BehrensG/ETH1CJTAG/hardware/project/ETH1CJTAG/ETH1CJTAG.ods

Id | Designator | Package | Quantity | Designation | Supplier and ref | Price (Euro) | Sum (Euro)
1 | R734,R724,R717,R1149,R221,R220,R715,R1148,R1146,R1144,R1135,R1134,R1133,R1132,R1131,R1130,R1129,R1128,R1125,R1124,R1123,R1122,R1121,R1120,R1119,R1118,R1117,R1109,R1016,R1015,R1012,R1011,R1008,R1007,R1004,R1003,R905,R722,R721,R720,R716,R703,R623,R619,R618,R612,R506,R503,R306,R305,R304,R303,R302,R301,R222,R216 | R_0603_G_Pad1.05x0.95mm_HandSolder | 56 | 10k | 594-MCT06030C1002FP5 | 0.14 | 7.84
2 | R513,R907,R510 | R_1206_3216Metric_Pad1.42x1.75mm_HandSolder | 3 | 0/0.75W | 71-CRCW12060000Z0EAH | 0.4 | 1.2
3 | C518,C513,C512,C507 | C_1206_3216Metric_Pad1.42x1.75mm_HandSolder | 4 | 470p/2kV | 603-CC126KKX7RDBB471 | 0.28 | 1.12
4 | J801 | Socket_DIN41612-CaseC1-AC-Male-64Pin-2rows | 1 | C64AC | 617-09-03-164-6921 | 2.58 | 2.58
5 | M101 | 60817-096 | 1 | 60817-096 |  |  | 0
6 | R617,R616,R615,R613 | R_0603_1608Metric_Pad1.05x0.95mm_HandSolder | 4 | 10k/0.1% | 71-TNPW060310K0BEEN | 0.83 | 3.32
7 | C215,C211 | C_1206_3216Metric_Pad1.42x1.75mm_HandSolder | 2 | 1n/2kV | 603-CC206KKX7RDBB102 | 0.37 | 0.74
8 | R204,R1147,R203,R202,R201 | R_0603_1608Metric_Pad1.05x0.95mm_HandSolder | 5 | 49R9 | 594-MCT06030C4999FP5 | 0.23 | 1.15
9 | C210,C201,C1104,C704,C1105,C1101,C1009,C1008,C1007,C1006,C1005,C1001,C911,C909,C907,C906,C905,C904,C903,C902,C901,C724,C723,C722,C721,C720,C719,C718,C717,C716,C715,C714,C713,C712,C707,C706,C702,C630,C629,C628,C627,C626,C622,C621,C620,C619,C616,C612,C609,C607,C606,C413,C412,C409,C406,C403,C303,C302,C301,C212,C207,C206,C205,C204,C202 | C_0603_A_Pad1.05x0.95mm_HandSolder | 65 | 100n | 80-C0603C104K5RAUTLR | 0.13 | 8.45
10 | U1101 | GCS2 | 1 | chiliSOM | NC | 0 | 0
11 | D602 | D_SMA | 1 | SK33A | 833-SK33A-LTP | 0.508 | 0.508
12 | L201 | 749010012A | 1 | 749010012A | 710-749010012A | 3.21 | 3.21
13 | U201,U203 | SO8E | 2 | LC03-3.3 | 947-LC03-3.3.TBT | 3.53 | 7.06
14 | J802 | 615008145221 | 1 | 615008145221 | 710-615008145221 | 3.77 | 3.77
15 | U706 | LQFP-64_10x10mm_P0.5mm | 1 | FT2232H | 895-FT2232HL | 5.86 | 5.86
16 | L403,L402,L401 | 744233121 | 3 | 744233121 | 710-744233121 | 1.25 | 3.75
17 | D1102 | D_SOD-323 | 1 | PMEG4005AEA | 771-PMEG4005AEAZ | 0.419 | 0.419
18 | D901 | D_SMB | 1 | SMBJ5.0A | 581-SMBJ5.0A | 0.48 | 0.48
19 | D603,D505 | D_SMB | 2 | P6SMB30CA | 652-P6SMB30CA | 0.384 | 0.768
20 | D502 | D_SMB | 1 | P6SMB6.8CA | 576-P6SMB6.8CA | 0.402 | 0.402
21 | U504 | SOT-23-6_Handsoldering | 1 | MAX5902 | 700-MAX5902ACEUTT | 4.09 | 4.09
22 | U302,U301,U204 | SOT-363_SC-70-6 | 3 | 82400274 | 710-82400274 | 0.9 | 2.7
23 | D714,D708,D707,D703,D702,D701,D704 | SOT-23 | 7 | BAT54S | 771-BAT54SWF | 0.175 | 1.225
24 | L1101 | CDRH74 | 1 | 851-CDRH74NP-180MC | 851-CDRH74NP-180MC | 0.943 | 0.943
25 | U711,U611 | SOT-23-5 | 2 | TLV75533PDBV | 595-TLV75533PDBVR | 0.541 | 1.082
26 | U502,U501 | SOT-23-6 | 2 | TPS61073 | 595-TPS61073DDCR | 1.14 | 2.28
27 | U404,U402,U401 | SOT-23-5 | 3 | 824011 | 710-824011 | 0.77 | 2.31
28 | U710,U709,U707,U705,U704,U703,U702,U701 | SOT-353_SC-70-5 | 8 | NC7SZ125 | 512-NC7SZ125P5X | 0.314 | 2.512
29 | R712,R711,R209,R208,R207,R206,R205,R1115,R1114,R1113,R1112,R1111,R1110,R627,R626,R215,R211,R210 | R_0603_H_Pad1.05x0.95mm_HandSolder | 18 | 22 | 652-CRT0603FY22R0ELF | 0.21 | 3.78
30 | R1145,R1104,R1103,R1102,R1101,R730,R718,R709,R611 | R_0603_E_Pad1.05x0.95mm_HandSolder | 9 | 0 | 71-RCS06030000Z0EC | 0.12 | 1.08
31 | J1103 | PinHeader_2x10_P1.27mm_Vertical_SMD | 1 | Conn_02x10_Counter_Clockwise | NC | 0 | 0
32 | C517 | CP_Elec_8x6.9 | 1 | 100u/50V | EEE-FP1H101AV | 0.999 | 0.999
33 | Y701,Y601 | ECX-2236 | 2 | ECS-120-8-36-CKM-TR | 520-120-8-36-CKMT | 0.533 | 1.066
34 | Y602 | ABS06W | 1 | 32.768kHz | NC | 0 | 0
35 | Y201 | ECX-2236 | 1 | ECS-250-8-36CKM-TR | 520-ECS-250-8-36CKM | 0.882 | 0.882
36 | U1005,U1004,U1002,U1001,U608,U607,U603 | SOIC-8_3.9x4.9mm_P1.27mm | 7 | TLC272 | 595-TLC272CDR | 1.03 | 7.21
37 | U1003 | TSSOP-16_4.4x5mm_P0.65mm | 1 | ADS7828 | 595-ADS7828E/2K5 | 6.55 | 6.55
38 | U906,U712,U604,U506 | AQY212GS | 4 | AQY212GS | 769-AQY212GS | 2.77 | 11.08
39 | U905,U904,U902 | SOT-23-6 | 3 | SN74LVC1T45DBV | 595-SN74LVC1T45DBVR | 0.507 | 1.521
40 | U903 | SOIC-16W_7.5x10.3mm_P1.27mm | 1 | ADuM5402 | 584-ADUM5402ARWZ-R | 9.81 | 9.81
41 | U901 | TSSOP-14_4.4x5mm_P0.65mm | 1 | 74AC125 | 863-MC74AC125DTR2G | 0.402 | 0.402
42 | U713 | SO-8_3.9x4.9mm_P1.27mm | 1 | IRF7455 | 942-IRF7455TRPBF | 0.961 | 0.961
43 | U708 | SOIC-8_3.9x4.9mm_P1.27mm | 1 | 93LC56 | 579-93LC56T/SN | 0.445 | 0.445
44 | U613 | MSOP-8_3x3mm_P0.65mm | 1 | 24LC256 | 579-24LC256-E/MS | 0.769 | 0.769
45 | U612 | LQFP-64_10x10mm_P0.5mm | 1 | STM32F405RGT6 | 511-STM32F405RGT6 | 9.24 | 9.24
46 | U610 | SOT-23 | 1 | REF3025 | 595-REF3025AIDBZR | 1.21 | 1.21
47 | U609 | TSSOP-14_4.4x5mm_P0.65mm | 1 | MCP4922-ESL | 579-MCP4922-E/SL | 2.35 | 2.35
48 | U606 | TSSOP-14_4.4x5mm_P0.65mm | 1 | MCP3204 | 579-MCP3204T-CI/ST | 2.85 | 2.85
49 | U605 | SOIC-8_3.9x4.9mm_P1.27mm | 1 | MAX4080FASA+ | 700-MAX4080FASA | 1.57 | 1.57
50 | U602 | SOIC-8_3.9x4.9mm_P1.27mm | 1 | LM334M | 926-LM334MX/NOPB | 0.76 | 0.76
51 | U601 | DD-PAK | 1 | LT3080EQ | 584-LT3080EQ#PBF | 4.65 | 4.65
52 | U505 | TEL10 | 1 | TEL 10-2415WI | 495-TEL10-2415WI | 25.33 | 25.33
53 | U503 | TEL10 | 1 | TEL 10-2411WI | 495-TEL10-2411WI | 25.33 | 25.33
54 | U403 | QFN-16-1EP_4x4mm_P0.65mm_EP2.1x2.1mm | 1 | FT230XQ | 895-FT230XQ-R | 1.78 | 1.78
55 | U202 | QFN-24-1EP_4x4mm_P0.5mm_EP2.6x2.6mm | 1 | LAN8720A | 579-LAN8720ACPABC | 0.908 | 0.908
56 | SW1101 | TDA06H0B1 | 1 | TDA06H0SB1 | 611-TDA06H0SB1 | 1.87 | 1.87
57 | R1143,R1142,R218,R217 | R_0603_1608Metric_Pad1.05x0.95mm_HandSolder | 4 | 470 | 279-CRGP0603F470R | 0.1 | 0.4
58 | R1141,R1140,R1139,R1138,R1137,R1136 | R_0603_I_Pad1.05x0.95mm_HandSolder | 6 | 47k | 71-CRCW060347K0FKEAH | 0.17 | 1.02
59 | R1127 | R_0603_1608Metric_Pad1.05x0.95mm_HandSolder | 1 | 680k | 71-CRCW0603680KFKEAC | 0.15 | 0.15
60 | R1126 | R_0603_1608Metric_Pad1.05x0.95mm_HandSolder | 1 | 130k | 71-CRCW0603130KFKEAC | 0.16 | 0.16
61 | R1116 | R_0603_1608Metric_Pad1.05x0.95mm_HandSolder | 1 | 75k | 71-CRCW060375K0FKEAC | 0.16 | 0.16
62 | R1108 | R_0603_1608Metric_Pad1.05x0.95mm_HandSolder | 1 | 1k5 | 71-CRCW06031K50FKEAC | 0.1 | 0.1
63 | R1107,R1106,R608 | R_0603_1608Metric_Pad1.05x0.95mm_HandSolder | 3 | 330 | 71-CRCW0603330RFKEAC | 0.1 | 0.3
64 | R1105 | R_0603_1608Metric_Pad1.05x0.95mm_HandSolder | 1 | 523 | 71-CRCW0603-523-E3 | 0.1 | 0.1
65 | R1014,R1006,R1002 | R_0603_1608Metric_Pad1.05x0.95mm_HandSolder | 3 | 5k05 | 71-CRCW0603-5.05K-E3 | 0.1 | 0.3
66 | R1013,R1010,R1009,R1005 | R_0603_1608Metric_Pad1.05x0.95mm_HandSolder | 4 | 13k | 71-CRCW060313K0FKEAC | 0.1 | 0.4
67 | R1001,R631,R630,R622,R507 | R_0603_J_Pad1.05x0.95mm_HandSolder | 5 | 100k | 279-CRGP0603F100K | 0.1 | 0.5
68 | R909,R908,R727,R603,R512,R511 | R_0603_1608Metric_Pad1.05x0.95mm_HandSolder | 6 | 422 | 667-ERJ-3EKF4220V | 0.1 | 0.6
69 | R906 | R_0603_1608Metric_Pad1.05x0.95mm_HandSolder | 1 | 51R1 | 71-RCS060351R1FKEA | 0.14 | 0.14
70 | R904 | R_0603_1608Metric_Pad1.05x0.95mm_HandSolder | 1 | 47 | 71-RCS060347R0FKEA | 0.14 | 0.14
71 | R903 | R_0603_1608Metric_Pad1.05x0.95mm_HandSolder | 1 | 100 | 71-CRCW0603100RFKEAC | 0.1 | 0.1
72 | R902 | R_0603_1608Metric_Pad1.05x0.95mm_HandSolder | 1 | 14k7 | 71-CRCW060314K7FKEAC | 0.15 | 0.15
73 | R901,R733,R732,R731,R729,R728,R621 | R_0603_P_Pad1.05x0.95mm_HandSolder | 7 | 1k | 71-CRCW06031K00FKEAC | 0.15 | 1.05
74 | R726,R725,R719,R710,R708,R702,R701 | R_0603_F_Pad1.05x0.95mm_HandSolder | 7 | 82 | 71-RCS060382R0FKEA | 0.14 | 0.98
75 | R723 | R_0603_1608Metric_Pad1.05x0.95mm_HandSolder | 1 | 2k2 | 71-RCS06032K20FKEA | 0.14 | 0.14
76 | R714 | R_0603_1608Metric_Pad1.05x0.95mm_HandSolder | 1 | 12k | 71-RCS060312K0FKEA | 0.14 | 0.14
77 | R713,R633,R632,R629,R628,R620 | R_0603_K_Pad1.05x0.95mm_HandSolder | 6 | 4k7 | 71-CRCW06034K70FKEAC | 0.17 | 1.02
78 | R707 | R_0603_1608Metric_Pad1.05x0.95mm_HandSolder | 1 | 22k | 71-RCS060322K0FKEA | 0.14 | 0.14
79 | R706,R704 | R_0603_1608Metric_Pad1.05x0.95mm_HandSolder | 2 | 270 | 71-RCS0603270RFKEA | 0.14 | 0.28
80 | R705 | R_0603_1608Metric_Pad1.05x0.95mm_HandSolder | 1 | 15k | 71-CRCW060315K0FKEAC | 0.16 | 0.16
81 | R625,R624 | R_0603_1608Metric_Pad1.05x0.95mm_HandSolder | 2 | 560 | 71-RCS0603560RFKEA | 0.14 | 0.28
82 | R614 | R_0603_L_Pad1.05x0.95mm_HandSolder | 1 | 3k2 | 660-RN73H1JT3201F100 | 0.22 | 0.22
83 | R610,R602 | R_0603_1608Metric_Pad1.05x0.95mm_HandSolder | 2 | 100/0.1% | 660-RN73R1JTD1000B25 | 0.42 | 0.84
84 | R609 | R_0603_1608Metric_Pad1.05x0.95mm_HandSolder | 1 | 1k/0.1% | 660-RN73R1JTD1001B25 | 0.42 | 0.42
85 | R607,R606 | R_0603_1608Metric_Pad1.05x0.95mm_HandSolder | 2 | 22k/0.1% | 667-ERJ-PB3B2202V | 0.25 | 0.5
86 | R605,R604 | R_0603_1608Metric_Pad1.05x0.95mm_HandSolder | 2 | 50k/0.1% | 71-PNM0603E5002BST1 | 2.17 | 4.34
87 | R601 | WSR | 1 | WSR21R000FEB | 71-WSR21R000FEK | 1.79 | 1.79
88 | R509 | R_0603_1608Metric_Pad1.05x0.95mm_HandSolder | 1 | 370 | 603-RT0603DRE07370RL | 0.22 | 0.22
89 | R508 | R_0805_2012Metric_Pad1.15x1.40mm_HandSolder | 1 | 6k8/0.5W | 667-ERJ-P06F6801V | 0.17 | 0.17
90 | R505,R502 | R_0603_1608Metric_Pad1.05x0.95mm_HandSolder | 2 | 20k | 755-ESR03EZPF2002 | 0.12 | 0.24
91 | R504,R501 | R_0603_1608Metric_Pad1.05x0.95mm_HandSolder | 2 | 180k | 71-CRCW0603180KFKEAC | 0.1 | 0.2
92 | R402,R401 | R_0603_G_Pad1.05x0.95mm_HandSolder | 2 | 22 | 71-CRCW060322R0FKEAC | 0.1 | 0.2
93 | R219 | R_1206_3216Metric_Pad1.42x1.75mm_HandSolder | 1 | 1M/1kV | 756-HVC1206-1M0FT3 | 0.82 | 0.82
94 | R214,R213 | R_0603_1608Metric_Pad1.05x0.95mm_HandSolder | 2 | 75/1% | 71-CRCW060375R0FKEAC | 0.1 | 0.2
95 | R212 | R_0603_1608Metric_Pad1.05x0.95mm_HandSolder | 1 | 12k1 | 71-CRCW060312K1FKEAC | 0.16 | 0.16
96 | Q705,Q704,Q703,Q702,Q603 | SOT-23 | 5 | BC847 | 771-BC847B-T/R | 0.114 | 0.57
97 | Q701 | SOT-23 | 1 | 2SD1048 | 863-2SD1048-7-TB-E | 0.437 | 0.437
98 | Q602,Q601 | SOT-23 | 2 | MMBT3904 | 621-MMBT3904-F | 0.096 | 0.192
99 | Q502 | SOT-23 | 1 | TSM2323 | 821-TSM2323CXRFG | 0.648 | 0.648
100 | Q501 | TO-252-2_Rectifier | 1 | IRFR5410 | 942-IRFR5410TRPBF | 1.18 | 1.18
101 | L901 | CW252016 | 1 | CW252016-R33G | 652-CW252016-R33J | 0.332 | 0.332
102 | L504,L503 | 7448014501 | 2 | 7448014501 | 710-7448014501 | 8.7 | 17.4
103 | L502,L501 | 744031004 | 2 | 4u7 | 710-744031004 | 1.43 | 2.86
104 | K705,K704,K703,K702,K701,K602,K601 | SA | 7 | TQ2SA-5V | 769-TQ2SA-5V | 3.21 | 22.47
105 | J1102 | PinHeader_1x03_P2.54mm_Vertical | 1 | Conn_01x03_Male | NC | 0 | 0
106 | J1101 | PinHeader_1x02_P2.54mm_Vertical | 1 | Conn_01x02 | NC | 0 | 0
107 | J601 | PinHeader_2x05_P1.27mm_Vertical | 1 | Conn_02x05 | 649-221111-00010T4LF | 0.68 | 0.68
108 | J401 | USB_Micro-B_Molex-105133-0001 | 1 | 105133-0001 | 538-105133-0001 | 0.821 | 0.821
109 | J301 | 693071010811 | 1 | 693071010811 | 710-693071010811 | 2.66 | 2.66
110 | FB1001,FB701,FB602,FB601,FB504,FB503,FB502,FB501,FB403,FB402,FB401,FB201 | R_0805_D_Pad1.15x1.40mm_HandSolder | 12 | 742792031 | 710-742792031 | 0.2 | 2.4
111 | F501 | Fuse_SMD2920 | 1 | MF-LSMF185/33X | 652-MF-LSMF185/33X-2 | 0.699 | 0.699
112 | D1104,D1103,D202 | LED_0603_1608Metric_Pad1.05x0.95mm_HandSolder | 3 | GREEN | 755-SMLD12EN1WT86 | 0.4 | 1.2
113 | D1101 | 150121M153000 | 1 | 150121M153000 | 710-150121M153000 | 0.873 | 0.873
114 | D903 | D_SOD-323_HandSoldering | 1 | SD36C-01FTG | 576-SD36C-01FTG | 0.428 | 0.428
115 | D902 | SOT-23 | 1 | BAV99 | 771-BAV99-T/R | 0.114 | 0.114
116 | D713,D712,D711,D710,D709,D604,D601 | D_SOD-123 | 7 | 1N4148W | 621-1N4148W-F | 0.14 | 0.98
117 | D706,D705 | LED_0603_1608Metric_Pad1.05x0.95mm_HandSolder | 2 | BLUE | 755-SMLD12BN1WT86 | 0.4 | 0.8
118 | D504 | LED_0603_1608Metric_Pad1.05x0.95mm_HandSolder | 1 | RED | 755-SML-D12V8WT86C | 0.34 | 0.34
119 | D503 | DO_214AA_REV | 1 | SM6T30AY | 511-SM6T30AY | 0.803 | 0.803
120 | D501 | D_SOD-123 | 1 | MMSZ5249B-E3-18 | 78-MMSZ5249B-E3-18 | 0.236 | 0.236
121 | D201 | LED_0603_1608Metric_Pad1.05x0.95mm_HandSolder | 1 | YELLLOW | 755-SML-D15MWT86C | 0.42 | 0.42
122 | C1103,C1003,C1002,C725,C711,C710,C705,C615,C614,C613,C510,C509,C506,C505,C503,C502,C414,C408,C407,C405,C404,C402,C401,C304,C203 | C_1206_AA_Pad1.42x1.75mm_HandSolder | 25 | 10u | 810-C3216X7R1E106K | 0.69 | 17.25
123 | C1102,C703,C701,C623,C608 | C_0805_M_Pad1.15x1.40mm_HandSolder | 5 | 4u7 | 80-C0805C475K3RAUTO | 0.75 | 3.75
124 | C1004,C910,C908,C611,C605,C209 | C_0603_T_Pad1.05x0.95mm_HandSolder | 6 | 1u | 80-C0603C105Z3VACTU | 0.28 | 1.68
125 | C912,C411,C410 | C_0603_1608Metric_Pad1.05x0.95mm_HandSolder | 3 | 47p | 80-C0603C470K5RAUTO | 0.27 | 0.81
126 | C709,C708,C625,C624,C214,C213 | C_0603_S_Pad1.05x0.95mm_HandSolder | 6 | 8p | 80-C0603C809C5GAUTO | 0.48 | 2.88
127 | C632,C631 | C_0603_1608Metric_Pad1.05x0.95mm_HandSolder | 2 | 2p2 | 80-C0603C229D5GAUTO | 0.28 | 0.56
128 | C618,C617 | C_0603_1608Metric_Pad1.05x0.95mm_HandSolder | 2 | 2u2 | 81-GRM188R61H225ME1J | 0.33 | 0.66
129 | C610 | C_0603_A_Pad1.05x0.95mm_HandSolder | 1 | 10u | 81-GRM188R61E106KA3D | 0.37 | 0.37
130 | C604,C603,C602,C516,C515 | C_1206_3216Metric_Pad1.42x1.75mm_HandSolder | 5 | 10u/50V | 963-UMK316BBJ106KL-T | 0.54 | 2.7
131 | C514,C508 | C_1206_3216Metric_Pad1.42x1.75mm_HandSolder | 2 | 2u2/100V | 603-CC1206KR0BB225 | 0.87 | 1.74
132 | C511 | CP_Elec_6.3x5.9 | 1 | 100u | 667-EEH-ZK1V101XV | 2.04 | 2.04
133 | C504,C501 | C_0603_1608Metric_Pad1.05x0.95mm_HandSolder | 2 | 27p | 80-C0603C270J5R | 0.25 | 0.5
134 | C208 | C_0603_1608Metric_Pad1.05x0.95mm_HandSolder | 1 | 470p | 80-C0603C471J5RAUTO | 0.17 | 0.17
135 | U614 | DCB | 1 | LT3493 | 584-3493EDCB-3TRMPBF | 6.11 | 6.11
136 | D606 | Case 457−04 | 1 | MBRM140 | 863-MBRM140T3G | 0.324 | 0.324
137 | L601 | MSS7348 | 1 | MSS7348-103MEB | 994-MSS7348-103MEB | 1.44 | 1.44
138 | Q604 | SOT-23 | 1 | TP0610T | 689-TP0610T-G | 0.63 | 0.63
139 | R635 | R_0603_1608Metric_Pad1.05x0.95mm_HandSolder | 1 | 270k | 71-CRCW0603270KFKEAC | 0.144 | 0.144
140 | C601 | C_1210_3225Metric_Pad1.42x2.65mm_HandSolder | 1 | GCM32EL8EH106KA07L | 81-GCM32EL8EH106KA7L | 1.14 | 1.14
141 | C635 | CP_Elec_8x5.4 | 1 | EEH-ZE1H680V | 667-EEH-ZE1H680V | 2.44 | 2.44
142 | D605 | D_SOD-323_HandSoldering | 1 | CMDSH-4E | 610-CMDSH-4ETR | 0.441 | 0.441
143 | U615 | DFN-8-1EP_2x2mm_P0.5mm_EP0.9x1.5mm | 1 | AD5110 | 584-A5110BCPZ80500R7 | 1.91 | 1.91
 |  |  |  |  |  |  | 361.40548
