BehrensG/ETH1CJTAG/hardware/project/PDF/ETH1CJTAG-B_SilkS.pdf

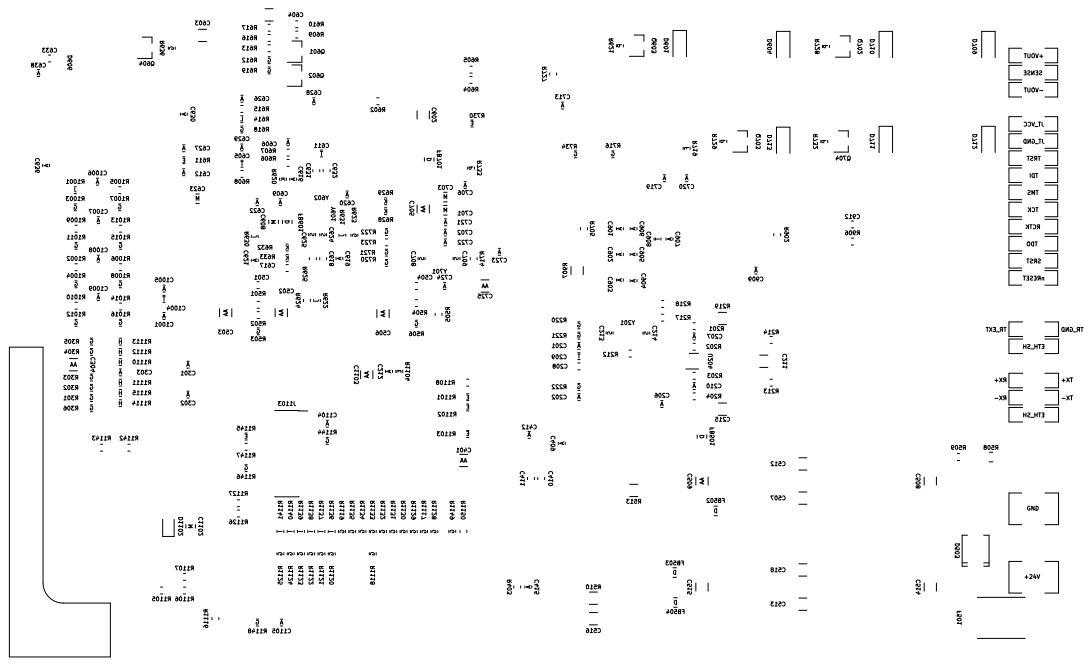
[picture p1: page 1]

RX+ TX+ RX- TX- GND
