BehrensG/ETH1CJTAG/hardware/project/PDF/ETH1CJTAG-F_SilkS.pdf

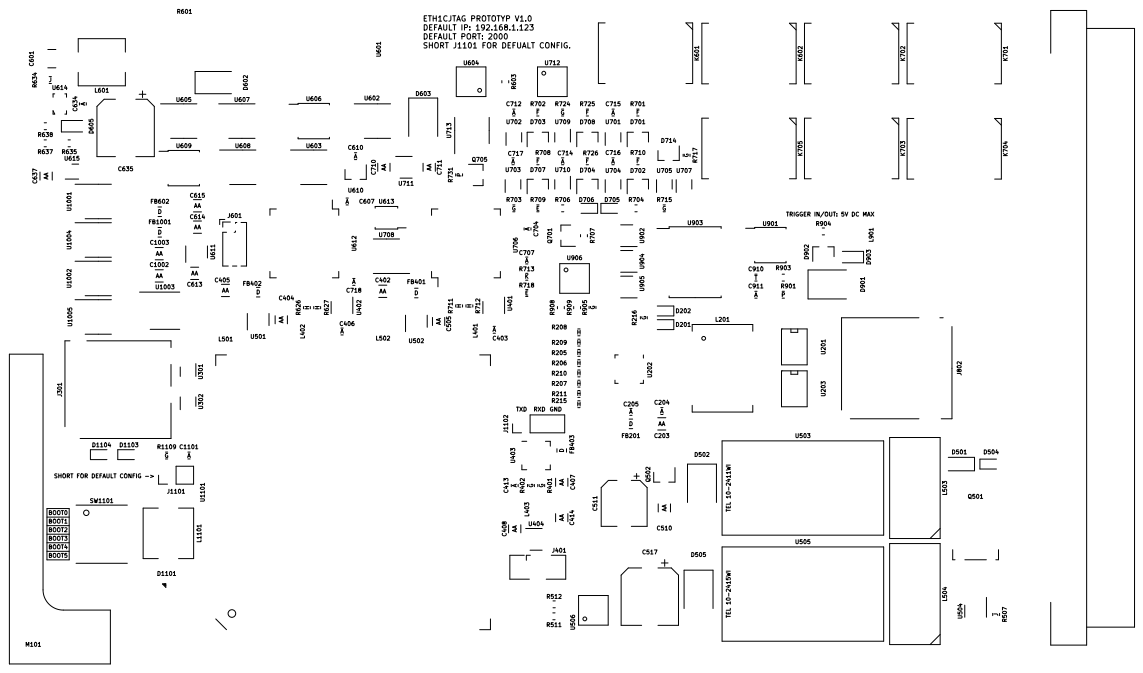
[picture p2: page 1]

TRIGGER IN/OUT: 5V DC MAX
