BehrensG/ETH1CJTAG/hardware/project/PDF/ETH1CJTAG-B_Mask.pdf

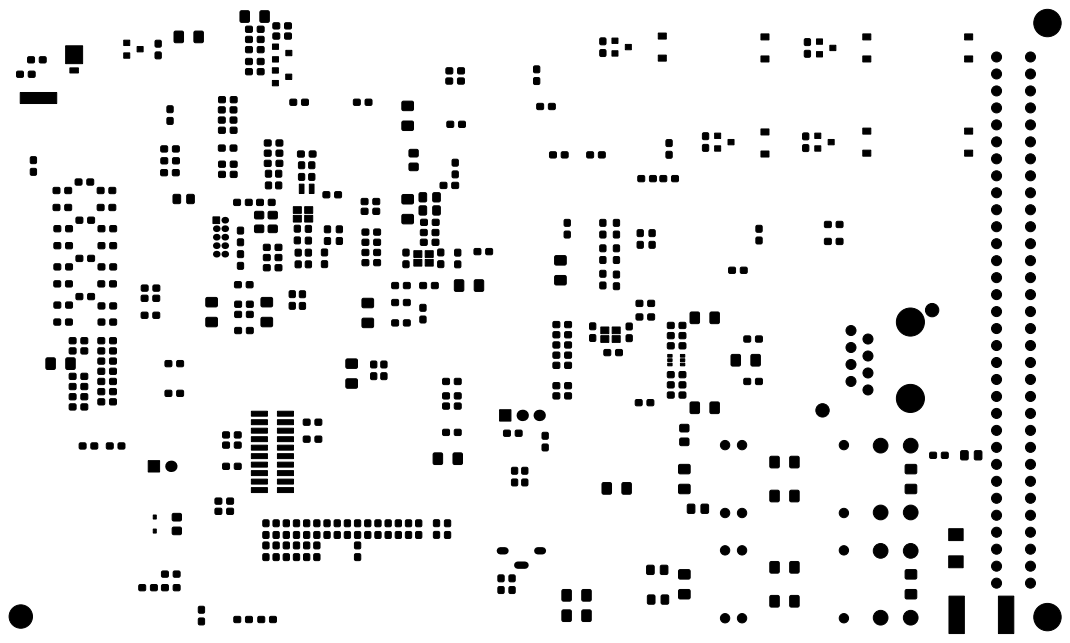
[picture p3: page 1]
