BehrensG/ETH1CJTAG/hardware/project/PDF/ETH1CJTAG-B_Paste.pdf

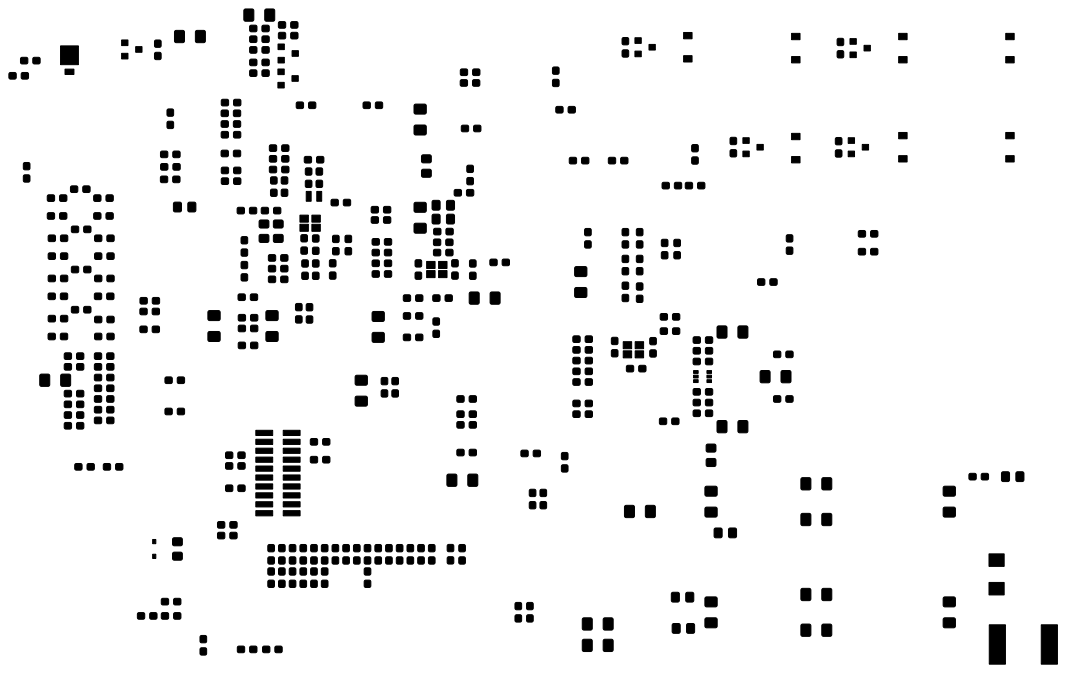
[picture p4: page 1]
