BehrensG/ETH1CJTAG/hardware/project/PDF/ETH1CJTAG-Bottom.pdf

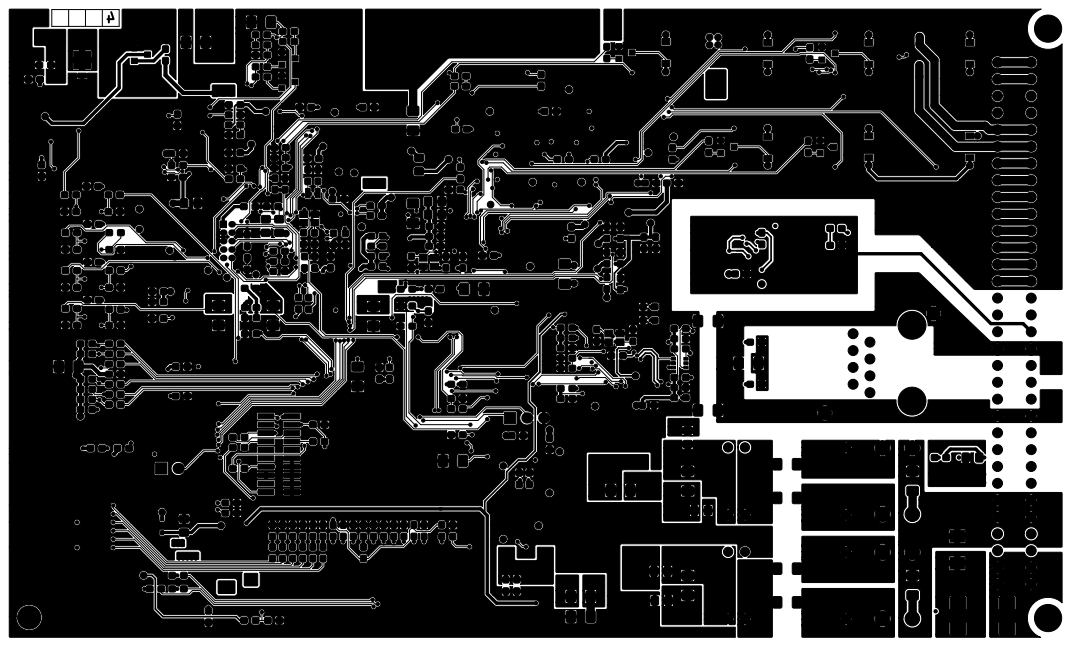
[picture p5: page 1]
