BehrensG/ETH1CJTAG/hardware/project/PDF/ETH1CJTAG-Dwgs_User.pdf

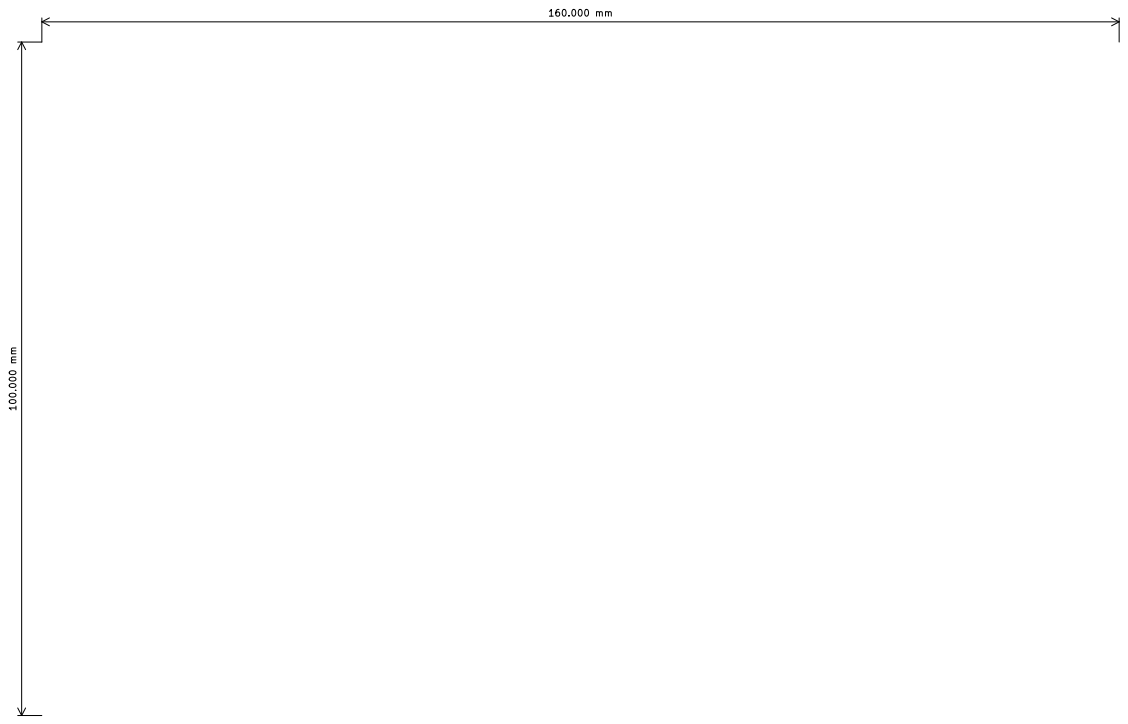
[picture p6: page 1]
