BehrensG/ETH1CJTAG/hardware/project/PDF/ETH1CJTAG-Edge_Cuts.pdf

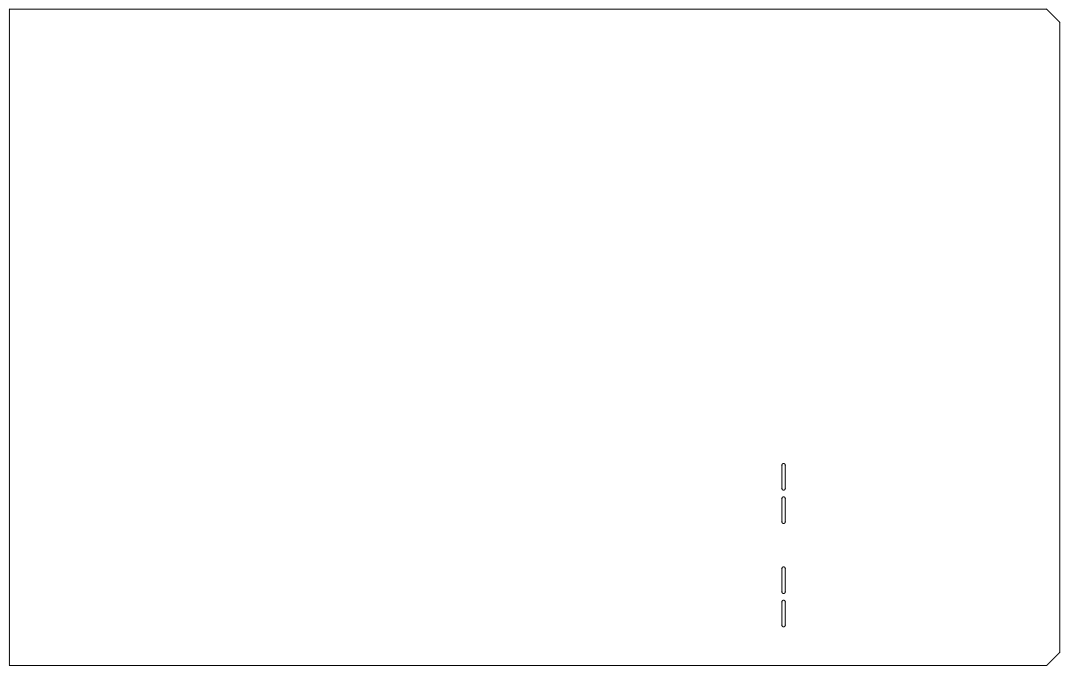
[picture p7: page 1]
