BehrensG/ETH1CJTAG/hardware/project/PDF/ETH1CJTAG-F_Mask.pdf

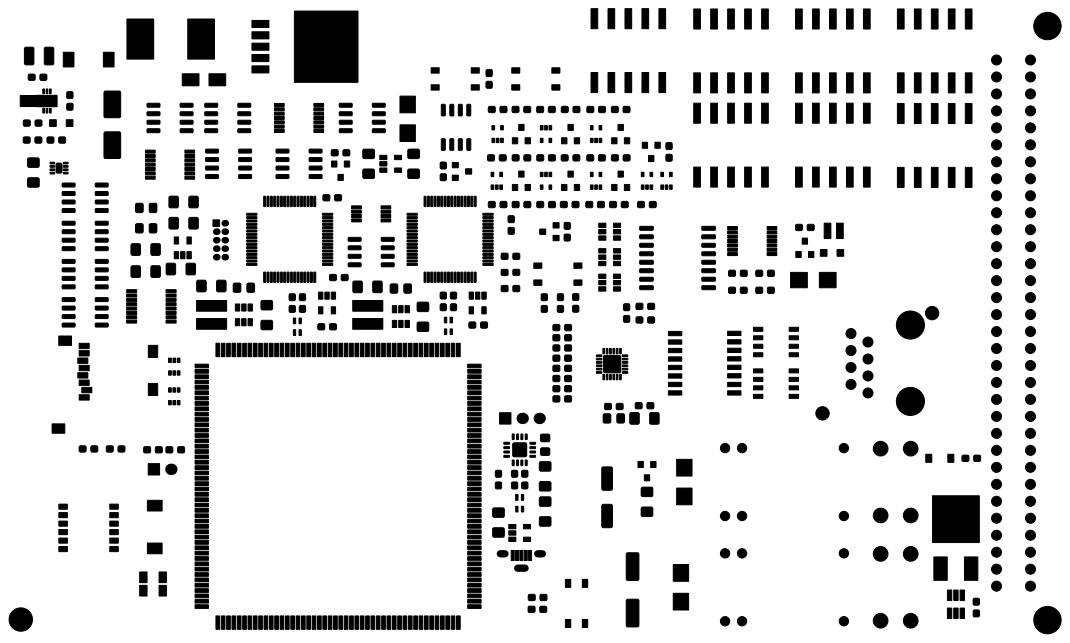
[picture p8: page 1]
