BehrensG/ETH1CJTAG/hardware/project/PDF/ETH1CJTAG-F_Paste.pdf

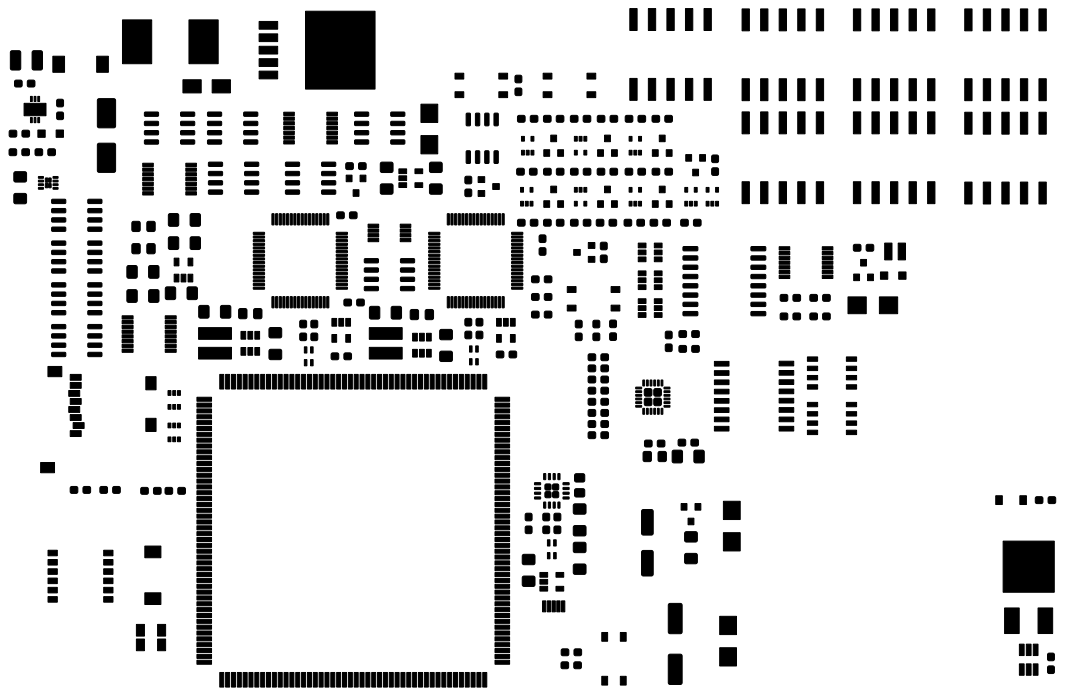
[picture p9: page 1]
