BehrensG/ETH1CJTAG/hardware/project/PDF/ETH1CJTAG-GND.pdf

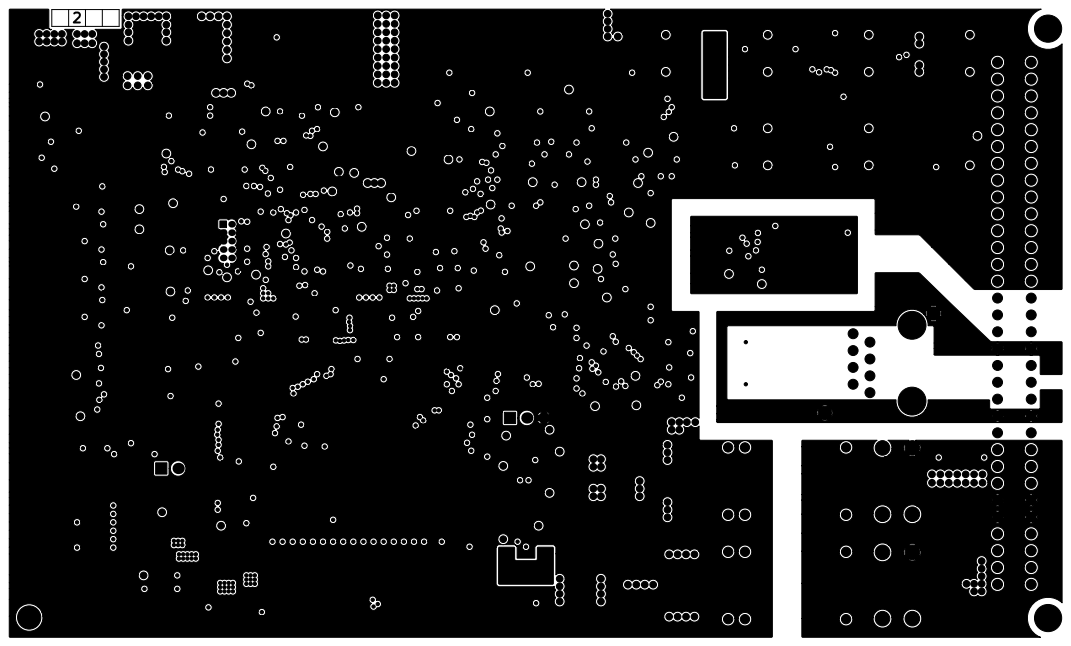
[picture p10: page 1]
