BehrensG/ETH1CJTAG/hardware/project/PDF/ETH1CJTAG-Power.pdf

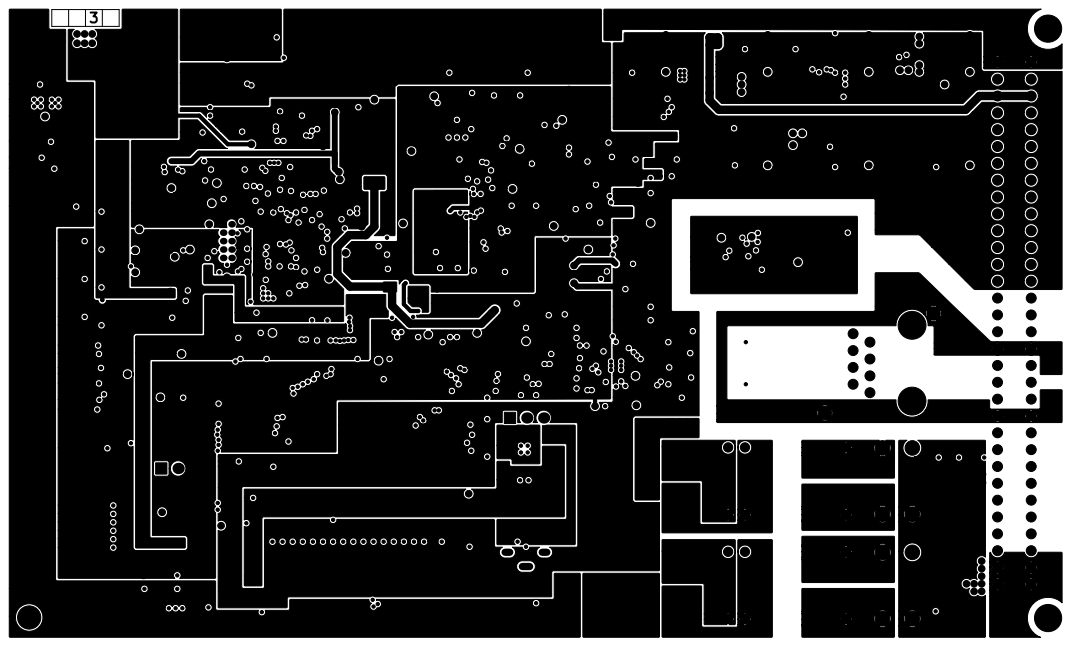
[picture p11: page 1]
