BehrensG/ETH1CJTAG/hardware/project/PDF/ETH1CJTAG-Top.pdf

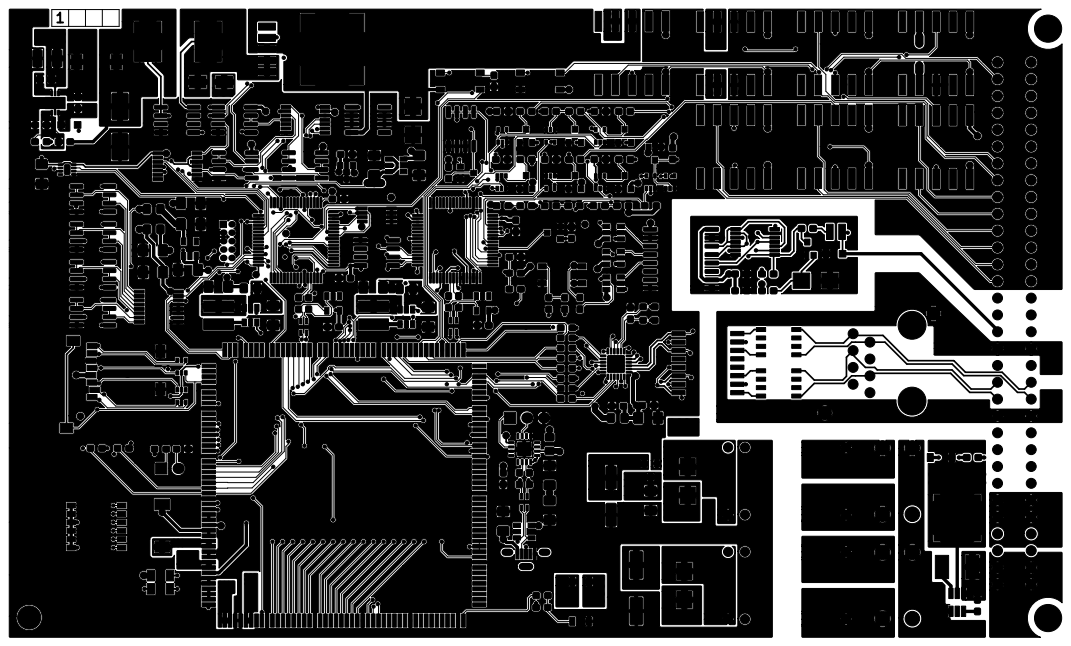
[picture p12: page 1]
