BehrensG/ETH1CJTAG/hardware/project/ETH1CJTAG/ETH1CJTAG.kicad_pcb

## KiCad design hardware/project/ETH1CJTAG/ETH1CJTAG.kicad_pcb (2019-07-21)

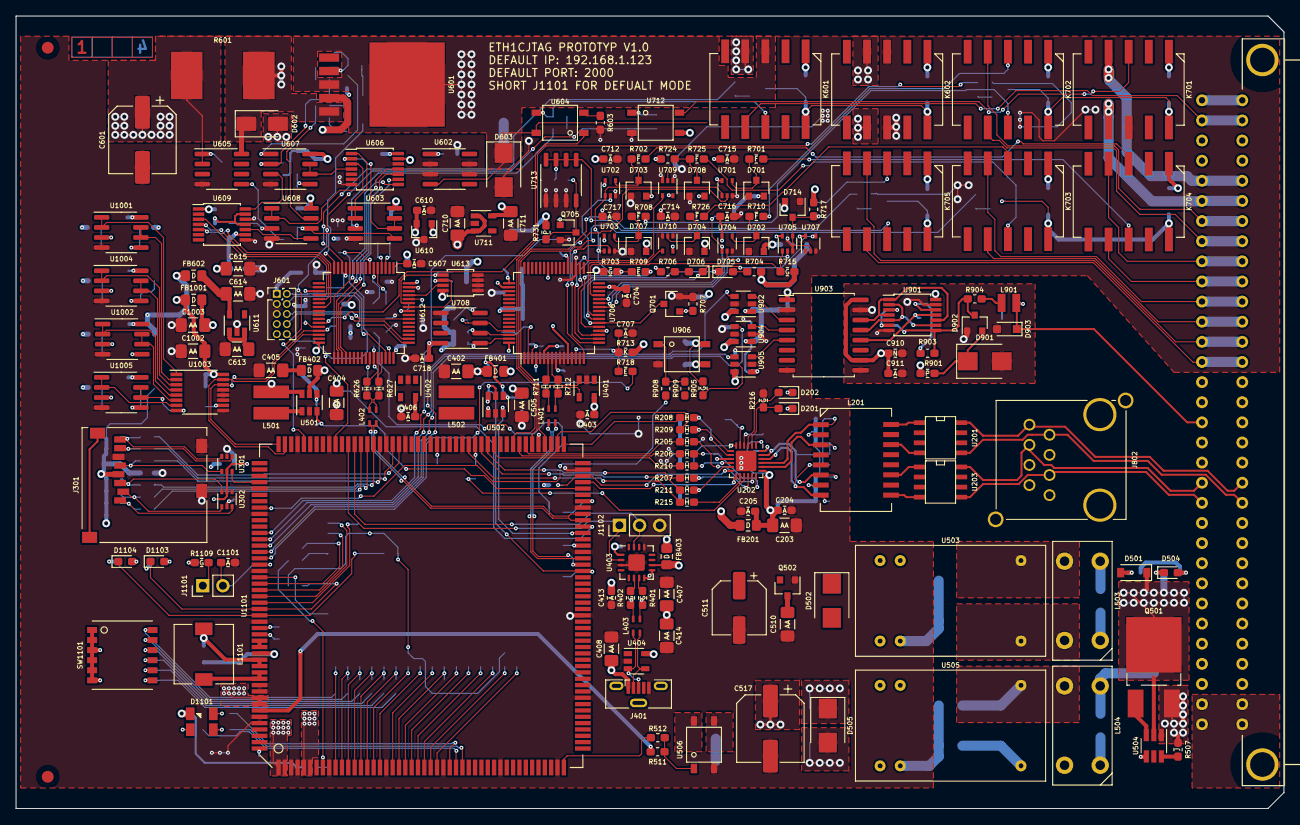
[picture p13: board ETH1CJTAG.kicad_pcb from above]

Board: 4 copper layers, 160.0 x 100.0 mm, 458 parts (0 on the bottom side), 342 nets.

Parts:
C201, C202, C204, C205, C206, C207, C210, C212, C301, C302, C303, C403, C406, C409, C412, C413, C606, C607, C609, C612, C616, C619, C620, C621, C622, C626, C627, C628, C629, C630, C702, C704, C706, C707, C712, C713, C714, C715, C716, C717, C718, C719, C720, C721, C722, C723, C724, C901, C902, C903, C904, C905, C906, C907, C909, C911, C1001, C1005, C1006, C1007, C1008, C1009, C1101, C1104, C1105: 100n; C_0603_A_Pad1.05x0.95mm_HandSolder
C203, C304, C401, C402, C404, C405, C407, C408, C414, C502, C503, C505, C506, C509, C510, C613, C614, C615, C705, C710, C711, C725, C1002, C1003, C1103: 10u; C_1206_AA_Pad1.42x1.75mm_HandSolder
C208: 470p; C_0603_1608Metric_Pad1.05x0.95mm_HandSolder
C209, C605, C611, C908, C910, C1004: 1u; R_0603_N_Pad1.05x0.95mm_HandSolder
C211, C215: 1n/2kV; C_1206_3216Metric_Pad1.42x1.75mm_HandSolder
C213, C214, C624, C625, C708, C709: 8p; C_0603_S_Pad1.05x0.95mm_HandSolder
C410, C411, C912: 47p; C_0603_1608Metric_Pad1.05x0.95mm_HandSolder
C501, C504: 27p; C_0603_1608Metric_Pad1.05x0.95mm_HandSolder
C507, C512, C513, C518: 470p/2kV; C_1206_3216Metric_Pad1.42x1.75mm_HandSolder
C508, C514: 2u2/100V; C_1206_3216Metric_Pad1.42x1.75mm_HandSolder
C511: 100u; CP_Elec_6.3x5.9
C515, C516, C602, C603, C604: 10u/50V; C_1206_3216Metric_Pad1.42x1.75mm_HandSolder
C517, C601: 220u/50V; CP_Elec_8x6.9
C608, C623, C701, C703, C1102: 4u7; C_0805_M_Pad1.15x1.40mm_HandSolder
C610: 10u; C_0603_A_Pad1.05x0.95mm_HandSolder
C617, C618: 2u2; C_0603_1608Metric_Pad1.05x0.95mm_HandSolder
C631, C632: 2p2; C_0603_1608Metric_Pad1.05x0.95mm_HandSolder
D201: YELLLOW; LED_0603_1608Metric_Pad1.05x0.95mm_HandSolder
D202, D1103, D1104: GREEN; LED_0603_1608Metric_Pad1.05x0.95mm_HandSolder
D501: MMSZ5249B-E3-18; D_SOD-123
D502: P6SMB6.8CA; D_SMB
D503: SM6T30AY; DO_214AA_REV
D504: RED; LED_0603_1608Metric_Pad1.05x0.95mm_HandSolder
D505, D603: P6SMB30CA; D_SMB
D601, D604, D709, D710, D711, D712, D713: 1N4148W; D_SOD-123
D602: SK33A; D_SMA
D701, D702, D703, D704, D707, D708, D714: BAT54S; SOT-23
D705, D706: LED; LED_0603_1608Metric_Pad1.05x0.95mm_HandSolder
D901: SMBJ5.0A; D_SMB
D902: BAV99; SOT-23
D903: SD36C-01FTG; D_SOD-323_HandSoldering
D1101: 150121M153000
D1102: PMEG4005AEA; D_SOD-323
F501: MF-LSMF185/33X; Fuse_SMD2920
FB201, FB401, FB402, FB403, FB501, FB502, FB503, FB504, FB601, FB602, FB701, FB1001: 742792031; R_0805_D_Pad1.15x1.40mm_HandSolder
FID101, FID102, FID103, FID104: Fiducial; Fiducial_1.5mm_Mask3mm
J301: 693071010811
J401: 105133-0001; USB_Micro-B_Molex-105133-0001
J601: Conn_02x05; PinHeader_2x05_P1.27mm_Vertical
J801: C64AC; Socket_DIN41612-CaseC1-AC-Male-64Pin-2rows
J802: 615008145221
J1101: Conn_01x02; PinHeader_1x02_P2.54mm_Vertical
J1102: Conn_01x03_Male; PinHeader_1x03_P2.54mm_Vertical
J1103: Conn_02x10_Counter_Clockwise; PinHeader_2x10_P1.27mm_Vertical_SMD
K601, K602, K701, K702, K703, K704, K705: TQ2SA-5V; SA
L201: 749010012A
L401, L402, L403: 744233121
L501, L502: 4u7; 744031004
L503, L504: 7448014501
L901: CW252016-R33G; CW252016
L1101: 851-CDRH74NP-180MC; CDRH74
Q501: IRFR5410; TO-252-2_Rectifier
Q502: TSM2323; SOT-23
Q601, Q602: MMBT3904; SOT-23
Q603, Q702, Q703, Q704, Q705: BC847; SOT-23
Q701: 2SD1048; SOT-23
R201, R202, R203, R204, R1147: 49R9; R_0603_1608Metric_Pad1.05x0.95mm_HandSolder
R205, R206, R207, R208, R209, R210, R211, R215, R626, R627, R711, R712, R1110, R1111, R1112, R1113, R1114, R1115: 22; R_0603_H_Pad1.05x0.95mm_HandSolder
R212: 12k1; R_0603_1608Metric_Pad1.05x0.95mm_HandSolder
R213, R214: 75/1%; R_0603_1608Metric_Pad1.05x0.95mm_HandSolder
R216, R220, R221, R222, R301, R302, R303, R304, R305, R306, R503, R506, R612, R618, R619, R623, R703, R715, R716, R720, R721, R722, R905, R1003, R1004, R1007, R1008, R1011, R1012, R1015, R1016, R1109, R1117, R1118, R1119, R1120, R1121, R1122, R1123, R1124, R1125, R1128, R1129, R1130, R1131, R1132, R1133, R1134, R1135, R1144, R1146, R1148: 10k; R_0603_G_Pad1.05x0.95mm_HandSolder
R217, R218, R1142, R1143: 470; R_0603_1608Metric_Pad1.05x0.95mm_HandSolder
R219: 1M/1kV; R_1206_3216Metric_Pad1.42x1.75mm_HandSolder
R401, R402: 22; R_0603_G_Pad1.05x0.95mm_HandSolder
R501, R504: 180k; R_0603_1608Metric_Pad1.05x0.95mm_HandSolder
R502, R505: 20k; R_0603_1608Metric_Pad1.05x0.95mm_HandSolder
R507, R622, R630, R631, R1001: 100k; R_0603_J_Pad1.05x0.95mm_HandSolder
R508: 6k8/0.5W; R_0805_2012Metric_Pad1.15x1.40mm_HandSolder
R509: 370; R_0603_1608Metric_Pad1.05x0.95mm_HandSolder
R510, R907: 0/0.75W; R_1206_3216Metric_Pad1.42x1.75mm_HandSolder
R511, R512, R603, R727, R908, R909: 420; R_0603_1608Metric_Pad1.05x0.95mm_HandSolder
R601: WSR21R000FEB; WSR
R602, R610: 100/0.1%; R_0603_1608Metric_Pad1.05x0.95mm_HandSolder
R604, R605: 50k/0.1%; R_0603_1608Metric_Pad1.05x0.95mm_HandSolder
R606, R607: 22k/0.1%; R_0603_1608Metric_Pad1.05x0.95mm_HandSolder
R608, R1106, R1107: 330; R_0603_1608Metric_Pad1.05x0.95mm_HandSolder
R609: 1k/0.1%; R_0603_1608Metric_Pad1.05x0.95mm_HandSolder
R611, R709, R718, R730, R1101, R1102, R1103, R1104, R1145: 0; R_0603_E_Pad1.05x0.95mm_HandSolder
R613, R615, R616, R617: 10k/0.1%; R_0603_1608Metric_Pad1.05x0.95mm_HandSolder
R614: 3k2; R_0603_L_Pad1.05x0.95mm_HandSolder
R620, R628, R629, R632, R633, R713: 4k7; R_0603_K_Pad1.05x0.95mm_HandSolder
R621, R728, R729, R731, R732, R733, R901: 1k; R_0603_P_Pad1.05x0.95mm_HandSolder
R624, R625: 560; R_0603_1608Metric_Pad1.05x0.95mm_HandSolder
R701, R702, R708, R710, R719, R725, R726: 82; R_0603_F_Pad1.05x0.95mm_HandSolder
R704, R706: 270; R_0603_1608Metric_Pad1.05x0.95mm_HandSolder
R705: 15k; R_0603_1608Metric_Pad1.05x0.95mm_HandSolder
R707, R717, R724: 22k; R_0603_1608Metric_Pad1.05x0.95mm_HandSolder
R714: 12k; R_0603_1608Metric_Pad1.05x0.95mm_HandSolder
R723: 2k2; R_0603_1608Metric_Pad1.05x0.95mm_HandSolder
R902: 14k7; R_0603_1608Metric_Pad1.05x0.95mm_HandSolder
R903: 100; R_0603_1608Metric_Pad1.05x0.95mm_HandSolder
R904: 47; R_0603_1608Metric_Pad1.05x0.95mm_HandSolder
R906: 51R1; R_0603_1608Metric_Pad1.05x0.95mm_HandSolder
R1002, R1006, R1014: 5k; R_0603_1608Metric_Pad1.05x0.95mm_HandSolder
R1005, R1009, R1010, R1013: 13k; R_0603_1608Metric_Pad1.05x0.95mm_HandSolder
R1105: 523; R_0603_1608Metric_Pad1.05x0.95mm_HandSolder
R1108: 1k5; R_0603_1608Metric_Pad1.05x0.95mm_HandSolder
R1116: 75k; R_0603_1608Metric_Pad1.05x0.95mm_HandSolder
R1126: 130k; R_0603_1608Metric_Pad1.05x0.95mm_HandSolder
R1127: 680k; R_0603_1608Metric_Pad1.05x0.95mm_HandSolder
R1136, R1137, R1138, R1139, R1140, R1141: 47k; R_0603_I_Pad1.05x0.95mm_HandSolder
SW1101: TDA06H0B1
U201, U203: LC03-3.3; SO8E
U202: LAN8720A; QFN-24-1EP_4x4mm_P0.5mm_EP2.6x2.6mm
U204, U301, U302: 82400274; SOT-363_SC-70-6
U401, U402, U404: 824011; SOT-23-5
U403: FT230XQ; QFN-16-1EP_4x4mm_P0.65mm_EP2.1x2.1mm
U501, U502: TPS61073; SOT-23-6
U503: TEL 10-2411WI; TEL10
U504: MAX5902; SOT-23-6_Handsoldering
U505: TEL 10-2415WI; TEL10
U506, U604, U712, U906: AQY212GS
U601: LT3080EQ; DD-PAK
U602: LM334M; SOIC-8_3.9x4.9mm_P1.27mm
U603, U607, U608, U1001, U1002, U1004, U1005: TLC272; SOIC-8_3.9x4.9mm_P1.27mm
U605: MAX4080FASA+; SOIC-8_3.9x4.9mm_P1.27mm
U606: MCP3204; TSSOP-14_4.4x5mm_P0.65mm
U609: MCP4922-ESL; TSSOP-14_4.4x5mm_P0.65mm
U610: REF3025; SOT-23
U611, U711: TLV75533PDBV; SOT-23-5
U612: STM32F405RGT6; LQFP-64_10x10mm_P0.5mm
U613: 24LC256; MSOP-8_3x3mm_P0.65mm
U701, U702, U703, U704, U705, U707, U709, U710: NC7SZ125; SOT-353_SC-70-5
U706: FT2232H; LQFP-64_10x10mm_P0.5mm
U708: 93LC56; SOIC-8_3.9x4.9mm_P1.27mm
U713: IRF7455; SO-8_3.9x4.9mm_P1.27mm
U901: 74AC125; TSSOP-14_4.4x5mm_P0.65mm
U902, U904, U905: SN74LVC1T45DBV; SOT-23-6
U903: ADuM5402; SOIC-16W_7.5x10.3mm_P1.27mm
U1003: ADS7828; TSSOP-16_4.4x5mm_P0.65mm
U1101: chiliSOM; GCS2
Y201: ECS-250-8-36CKM-TR; ECX-2236
Y601, Y701: ECS-120-8-36-CKM-TR; ECX-2236
Y602: 32.768kHz; ABS06W

Connections:
3.3V_DBG: C412.1, U403.1, U403.8, U403.9
5V_ISO_TRIG: C909.1, C910.1, C911.1, R901.1, U901.14, U903.10, U903.16
5V_TRIG: C904.1, C905.1, C906.1, C907.1, C908.1, R905.2, R907.2, U902.1, U903.1, U904.1, U905.1, U906.4
5V_USB: C407.1, C413.1, C414.1, FB403.2, U403.10, U1101.5, U1101.6
+1.8V_JTAG: C705.1, C706.1, U706.12, U706.37, U706.49, U706.64
+2V5: C610.1, R611.2, U606.13, U609.11, U609.13, U610.2
+3.3VA: R511.2, R909.2, U1101.178
+3.3V_D: C201.1, C202.1, C301.1, C302.1, C303.1, C304.1, C901.1, C902.1, C903.1, C1003.1, C1104.1, D1101.1, FB201.2, FB1001.1, J301.4, J1103.3, R220.1, R221.1, R222.1, R301.1, R302.1, R303.1, R304.1, R305.1, R306.1, R1014.1, R1108.1, R1109.1, R1117.1, R1118.1, R1119.1, R1142.1, R1143.1, R1144.1, R1146.1, R1148.1, SW1101.1, SW1101.2, SW1101.3, SW1101.4, SW1101.5, SW1101.6, U202.9, U301.5, U302.5, U902.6, U904.6, U905.6, U1101.176, U1101.177
+3.3V_JTAG: C701.1, C702.1, C703.1, C704.1, C712.1, C713.1, C714.1, C715.1, C716.1, C717.1, C718.1, C719.1, C720.1, C721.1, C722.1, C723.1, C724.1, C725.1, D701.2, D702.2, D703.2, D704.2, D707.2, D708.2, D714.2, FB701.1, R703.1, R704.1, R705.2, R706.1, R713.1, R715.2, R716.2, R717.1, R720.1, R721.1, R722.1, R724.1, R731.2, R1002.1, U701.5, U702.5, U703.5, U704.5, U705.5, U706.4, U706.9, U706.20, U706.31, U706.42, U706.50, U706.56, U707.5, U708.8, U709.5, U710.5, U712.3
+3.3V_PSU: C611.1, C612.1, C615.1, C619.1, C620.1, C621.1, C622.1, C623.1, C626.1, C627.1, C628.1, FB601.1, FB602.1, J601.1, R614.1, R620.1, R622.1, R628.1, R629.1, R632.1, R633.1, R1006.1, U603.8, U606.14, U607.8, U609.1, U609.9, U610.1, U612.19, U612.32, U612.48, U612.64, U613.8
+3.3V_TEST: C1002.1, C1004.1, C1005.1, C1006.1, C1007.1, C1008.1, C1009.1, FB1001.2, U1001.8, U1002.8, U1003.16, U1004.8, U1005.8
+5VD: C511.1, D601.1, D604.1, D709.1, D710.1, D711.1, D712.1, D713.1, K601.1, K602.1, K701.1, K702.1, K703.1, K704.1, K705.1, Q502.2, R907.1, R1005.1, U906.3, U1101.1, U1101.2
+24V: F501.1, J801.A31, J801.A32, J801.C31, J801.C32
+24V_PSU: C601.1, C629.1, C630.1, R510.1, R601.2, R1001.1, U506.4, U601.4, U605.1, U605.2, U608.8
/Connector/+VOUT: J801.A1, J801.C1, K601.4
/Connector/-VOUT: J801.A3, J801.C3, K602.4, K602.7
/Connector/EXT_TRIG: C912.1, D903.1, J801.A17, L901.1
/Connector/JTAG_GND: J801.A6, J801.C6, K701.7
/Connector/JTAG_VCC: J801.A5, J801.C5, K701.4
/Connector/RCTK: J801.A11, J801.C11, K703.4
/Connector/RX+: J801.A20, J802.3, U203.8
/Connector/RX-: J801.A21, J802.6, U203.5
/Connector/SENSE: J801.A2, J801.C2, K601.7
/Connector/SRST: J801.A13, J801.C13, K705.4
/Connector/TCK: J801.A10, J801.C10, K704.7
/Connector/TDI: J801.A8, J801.C8, K702.7
/Connector/TDO: J801.A12, J801.C12, K703.7
/Connector/TMS: J801.A9, J801.C9, K704.4
/Connector/TRST: J801.A7, J801.C7, K702.4
/Connector/TX+: J801.C20, J802.1, U201.8
/Connector/TX-: J801.C21, J802.2, U201.5
/Connector/nRESET: J801.A14, J801.C14, K705.7
/Ethernet/ETH_CRS_DV: R211.2, U1101.106
/Ethernet/ETH_MDC: U202.13, U1101.89
/Ethernet/ETH_MDIO: R1108.2, U202.12, U1101.90
/Ethernet/ETH_MODE0: R208.1, R220.2, U202.8
/Ethernet/ETH_MODE1: R209.1, R221.2, U202.7
/Ethernet/ETH_MODE2: R211.1, R222.2, U202.11
/Ethernet/ETH_RD_N: L201.8, R204.2, U202.22, U204.1
/Ethernet/ETH_RD_P: L201.6, R203.2, U202.23, U204.3
/Ethernet/ETH_REFCLK: R215.2, U1101.108
/Ethernet/ETH_RESETn: C212.1, R1104.1, U202.15
/Ethernet/ETH_RXD0: R208.2, U1101.93
/Ethernet/ETH_RXD1: R209.2, U1101.94
/Ethernet/ETH_RXERR: R210.2, U1101.104
/Ethernet/ETH_TD_N: L201.3, R202.2, U202.20, U204.4
/Ethernet/ETH_TD_P: L201.1, R201.2, U202.21, U204.6
/Ethernet/ETH_TXD0: R205.2, U1101.99
/Ethernet/ETH_TXD1: R206.2, U1101.100
/Ethernet/ETH_TXEN: R207.2, U1101.105
/JTAG/3V3_JTAG_CTR: R727.2, U1101.134
/JTAG/FT_EECLK: R721.2, U706.62, U708.2
/JTAG/FT_EECS: R720.2, U706.63, U708.1
/JTAG/FT_EEDATA: R723.1, U706.61, U708.3
/JTAG/FT_JTAG_OE_N: R703.2, R709.1, U701.1, U702.1, U703.1
/JTAG/FT_RCTK: U706.24, U710.4
/JTAG/FT_SRST_N_IN: D706.1, U706.23, U707.4
/JTAG/FT_SRST_N_OE_N: R715.1, U705.1, U706.29
/JTAG/FT_SRST_N_OUT: U705.2, U706.27
/JTAG/FT_TCK_OUT: U701.2, U706.16
/JTAG/FT_TDI_OUT: U703.2, U706.17
/JTAG/FT_TDO_IN: U706.18, U709.4
/JTAG/FT_TMS_OUT: U702.2, U706.19
/JTAG/FT_TRST_N_OE_N: R716.1, U704.1, U706.28
/JTAG/FT_TRST_N_OUT: U704.2, U706.26
/JTAG/FT_VREF_N_IN: D705.1, Q701.3, U706.22
/JTAG/FT_~RESET: R718.2, U1101.154
/JTAG/F_USB1_D_N: L401.3, R712.2, U401.4
/JTAG/F_USB1_D_P: L401.2, R711.2, U401.3
/JTAG/JTAG_REL1: D711.2, D712.2, K703.10, K704.10, Q704.3
/JTAG/JTAG_REL2: D709.2, D710.2, K701.10, K702.10, Q702.3
/JTAG/JTAG_REL3: D713.2, K705.10, Q703.3
/JTAG/JTAG_REL_CTR1: R732.2, U1101.96
/JTAG/JTAG_REL_CTR2: R728.2, U1101.101
/JTAG/JTAG_REL_CTR3: R729.2, U1101.98
/JTAG/RCTK1: K703.3, R726.1
/JTAG/RCTK1_A: D704.3, R726.2, U710.2
/JTAG/SRST1: K705.3, R719.1
/JTAG/SRST1_A: D714.3, R717.2, R719.2, U705.4, U707.2
/JTAG/TCK1: K704.8, R701.1
/JTAG/TCK1_A: D701.3, R701.2, U701.4
/JTAG/TDI1: K702.8, R708.1
/JTAG/TDI1_A: D707.3, R708.2, U703.4
/JTAG/TDO1: K703.8, R725.1
/JTAG/TDO1_A: D708.3, R724.2, R725.2, U709.2
/JTAG/TMS1: K704.3, R702.1
/JTAG/TMS1_A: D703.3, R702.2, U702.4
/JTAG/TRST1: K702.3, R710.1
/JTAG/TRST1_A: D702.3, R710.2, U704.4
/JTAG/nRESET1: K705.8, R730.1, U713.5, U713.6, U713.7, U713.8
/JTAG/nRESET_OUT: R733.2, U1101.150
/PSU/CLIM: Q602.3, U612.16
/PSU/F_USB0_D_N: L402.2, R626.1, U402.4
/PSU/F_USB0_D_P: L402.3, R627.1, U402.3
/PSU/I2C_SCL: R632.2, U612.29, U1003.14, U1101.138
/PSU/I2C_SDA: R633.2, U612.30, U1003.15, U1101.137
/PSU/ISET: U608.5, U609.10
/PSU/NC\TDI: J601.8, U612.50
/PSU/PSU_ADC_CLK: U606.11, U612.34
/PSU/PSU_ADC_IOUT: C605.1, R608.1, U603.5, U608.6
/PSU/PSU_ADC_SDI: U606.9, U612.36
/PSU/PSU_ADC_SDO: U606.10, U612.35
/PSU/PSU_ADC_VOUT: C606.1, R604.1, R606.2, R607.2, U603.3
/PSU/PSU_ADC_~CS: U606.8, U612.33
/PSU/PSU_DAC_SCK: U609.4, U612.21
/PSU/PSU_DAC_SDI: U609.5, U612.23
/PSU/PSU_DAC_~CS: U609.3, U612.20
/PSU/PSU_I2C_SCL: R628.2, U612.58, U613.6
/PSU/PSU_I2C_SDA: R629.2, U612.59, U613.5
/PSU/PSU_NRST: C616.1, J601.10, R620.2, U612.7, U1101.129
/PSU/PSU_RELAY: D601.2, D604.2, K601.10, K602.10, Q603.3
/PSU/PSU_SENSE: U604.1, U612.27
/PSU/PSU_WP: U612.61, U613.7
/PSU/SWDCLK\TCK: J601.4, U612.49
/PSU/SWDIO\TMS: J601.2, U612.46
/PSU/SWO\TDO: J601.6, U612.55
/PSU/USB0_ID: R625.1, R1101.2, R1102.1
/PSU/VSET: U607.3, U609.14
/Power/ENA_24V_PSU: R512.2, U1101.46
/Power/USB0_DRVVBUS: R503.1, U501.3, U1101.88
/Power/USB1_DRVVBUS: R506.1, U502.3, U1101.81
/SOM/BOOT0: R1125.2, R1141.1, U1101.10
/SOM/BOOT1: R1124.2, R1140.1, U1101.11
/SOM/BOOT2: R1123.2, R1139.1, U1101.12
/SOM/BOOT3: R1122.2, R1138.1, U1101.13
/SOM/BOOT4: R1121.2, R1137.1, U1101.14
/SOM/BOOT5: R1120.2, R1136.1, U1101.15
/SOM/BOOT6: R1119.2, U1101.16
/SOM/BOOT7: R1135.1, U1101.17
/SOM/BOOT8: R1134.1, U1101.19
/SOM/BOOT9: R1118.2, R1133.1, U1101.20
/SOM/BOOT10: R1132.1, U1101.21
/SOM/BOOT11: R1131.1, U1101.22
/SOM/BOOT12: R1130.1, U1101.23
/SOM/BOOT13: R1129.1, U1101.24
/SOM/BOOT14: R1117.2, U1101.25
/SOM/BOOT15: R1128.1, U1101.26
/SOM/DBG_RXD: J1102.2, U403.15, U1101.126
/SOM/DBG_TXD: J1102.1, U403.2, U1101.127
/SOM/ENA_5V_TRIG: R908.2, U1101.146
/SOM/LED_BLUE: R1107.2, U1101.28
/SOM/LED_GREEN: R1106.2, U1101.30
/SOM/LED_RED: R1105.2, U1101.29
/SOM/SD_CD: J301.9, R306.2, U301.6, U1101.142
/SOM/SD_CLK: J301.5, R1110.2, U301.4
/SOM/SD_CMD: J301.3, R303.2, R1111.2, U302.6
/SOM/SD_DAT0: J301.7, R304.2, R1112.2, U301.1
/SOM/SD_DAT1: J301.8, R305.2, R1113.2, U301.3
/SOM/SD_DAT2: J301.1, R301.2, R1114.2, U302.3
/SOM/SD_DAT3: J301.2, R302.2, R1115.2, U302.1
/SOM/TRIG_EN: U902.4, U1101.153
/SOM/TRIG_IN: U905.4, U1101.151
/SOM/TRIG_OUT: U904.4, U1101.152
/SOM/USB0_D_N: L402.1, U1101.83
/SOM/USB0_D_P: L402.4, U1101.84
/SOM/USB1_D_N: L401.4, U1101.76
/SOM/USB1_D_P: L401.1, U1101.77
/SOM/chili_EMU0: D1104.1, J1103.7, R1144.2, U1101.163
/SOM/chili_EMU1: D1103.1, J1103.14, R1146.2, U1101.162
/SOM/chili_RESETn: C1105.1, R1147.2, R1148.2, U1101.8
/SOM/chili_TCK: J1103.6, R1145.2, U1101.158
/SOM/chili_TDI: J1103.2, U1101.160
/SOM/chili_TDO: J1103.4, U1101.159
/SOM/chili_TMS: J1103.1, U1101.161
/SOM/chili_~TRST: J1103.20, U1101.157
/Test/CH0: U1001.1, U1001.2, U1003.1
/Test/CH1: U1001.6, U1001.7, U1003.2
/Test/CH2: U1003.3, U1004.1, U1004.2
/Test/CH3: U1003.4, U1004.6, U1004.7
/Test/CH4: U1002.1, U1002.2, U1003.5
/Test/CH5: U1002.6, U1002.7, U1003.6
/Test/CH6: U1003.7, U1005.1, U1005.2
/Test/CH7: U1003.8, U1005.6, U1005.7
/Trigger/EXT_TRIG_SIGN: R902.1, U901.11, U903.12
/Trigger/TRIG_OUT_EN: U901.1, U901.4, U901.10, U903.14
/Trigger/TRIG_OUT_SIGN: U901.2, U901.5, U901.9, U903.13
/USB/DBG_USB_D_N: C410.1, L403.1, R401.1
/USB/DBG_USB_D_P: C411.1, L403.4, R402.1
/USB/F_DBG_USB_D_N: J401.2, L403.2, U404.4
/USB/F_DBG_USB_D_P: J401.3, L403.3, U404.3
DBG_USB_VCC: C408.1, C409.1, FB403.1, J401.1, U404.5
Earth: C211.2, C215.1, J801.A19, J801.A23, J801.C19, J801.C23, J802.SH, R219.1
GND: C909.2, C910.2, C911.2, D901.2, D902.1, D903.2, J801.C17, R906.2, U901.7, U901.13, U903.9, U903.15
GNDA: C201.2, C202.2, C203.2, C204.2, C205.2, C206.2, C207.2, C208.2, C209.2, C210.2, C212.2, C213.2, C214.2, C215.2, C301.2, C302.2, C303.2, C304.2, C401.2, C402.2, C403.2, C404.2, C405.2, C406.2, C407.2, C408.2, C409.2, C410.2, C411.2, C412.2, C413.2, C414.2, C502.2, C503.2, C505.2, C506.2, C510.2, C511.2, C516.2, C517.2, C601.2, C602.2, C603.2, C604.2, C605.2, C606.2, C607.2, C608.2, C609.2, C610.2, C611.2, C612.2, C613.2, C614.2, C615.2, C616.2, C617.2, C618.2, C619.2, C620.2, C621.2, C622.2, C623.2, C624.2, C625.2, C626.2, C627.2, C628.2, C629.2, C630.2, C631.2, C632.2, C701.2, C702.2, C703.2, C704.2, C705.2, C706.2, C707.2, C708.2, C709.2, C710.2, C711.2, C712.2, C713.2, C714.2, C715.2, C716.2, C717.2, C718.2, C719.2, C720.2, C721.2, C722.2, C723.2, C724.2, C725.2, C901.2, C902.2, C903.2, C904.2, C905.2, C906.2, C907.2, C908.2, C1001.2, C1002.2, C1003.2, C1004.2, C1005.2, C1006.2, C1007.2, C1008.2, C1009.2, C1101.2, C1102.1, C1103.2, C1104.2, C1105.2, D603.2, D701.1, D702.1, D703.1, D704.1, D707.1, D708.1, D714.1, FB502.2, FB504.2, J301.6, J301.10, J401.5, J601.3, J601.5, J1102.3, J1103.11, J1103.13, J1103.15, J1103.16, J1103.17, J1103.19, K602.3, K602.8, K701.8, Q502.1, Q601.2, Q602.2, Q603.2, Q701.2, Q702.2, Q703.2, Q704.2, Q705.2, R212.1, R216.2, R217.2, R218.2, R219.2, R502.2, R503.2, R505.2, R506.2, R602.2, R603.1, R606.1, R607.1, R613.2, R615.2, R618.2, R623.2, R630.1, R631.1, R707.1, R714.2, R1003.2, R1004.2, R1007.2, R1008.2, R1011.2, R1012.2, R1015.2, R1016.2, R1101.1, R1103.1, R1116.2, R1126.1, R1127.1, R1128.2, R1129.2, R1130.2, R1131.2, R1132.2, R1133.2, R1134.2, R1135.2, R1136.2, R1137.2, R1138.2, R1139.2, R1140.2, R1141.2, U202.25, U204.2, U301.2, U302.2, U401.2, U402.2, U403.3, U403.13, U403.17, U404.2, U501.2, U502.2, U506.2, U602.2, U602.3, U602.6, U602.7, U603.4, U605.4, U606.7, U606.12, U607.4, U608.4, U609.8, U609.12, U610.3, U611.2, U612.12, U612.18, U612.63, U613.1, U613.2, U613.3, U613.4, U701.3, U702.3, U703.3, U704.3, U705.3, U706.1, U706.5, U706.10, U706.11, U706.13, U706.15, U706.25, U706.35, U706.47, U706.51, U707.1, U707.3, U708.5, U709.1, U709.3, U710.1, U710.3, U711.2, U712.2, U713.1, U713.2, U713.3, U902.2, U902.5, U903.2, U903.8, U904.2, U904.5, U905.2, U906.2, U1001.4, U1002.4, U1003.9, U1003.11, U1003.12, U1003.13, U1004.4, U1005.4, U1101.3, U1101.4, U1101.9, U1101.18, U1101.27, U1101.36, U1101.45, U1101.55, U1101.68, U1101.78, U1101.85, U1101.91, U1101.97, U1101.109, U1101.118, U1101.121, U1101.130, U1101.135, U1101.143, U1101.147, U1101.156, U1101.164, U1101.174, U1101.175, U1101.179, U1101.180, Y201.2, Y201.4, Y601.2, Y601.4, Y701.2, Y701.4
GNDPWR: C508.2, C514.2, D503.2, D504.1, J801.A27, J801.A28, J801.C27, J801.C28, L503.2, L504.2, U504.4
unnamed: C203.1, C204.1, C205.1, C206.1, C207.1, C210.1, FB201.1, L201.2, L201.7, R201.1, R202.1, R203.1, R204.1, U202.1, U202.19
unnamed: C208.1, C209.1, U202.6
unnamed: C211.1, R213.2, R214.2
unnamed: C213.1, U202.5, Y201.1
unnamed: C214.1, U202.4, Y201.3
unnamed: C501.2, R501.2, R502.1, U501.4
unnamed: C504.2, R504.2, R505.1, U502.4
unnamed: C507.1, L503.4, U503.16
unnamed: C507.2, C509.2, C512.2, D502.2, FB502.1, U503.10
unnamed: C508.1, C514.1, D501.1, L503.1, L504.1, Q501.2, R508.1, U504.2
unnamed: C509.1, D502.1, FB501.1, U503.9
unnamed: C510.1, FB501.2, Q502.3
unnamed: C512.1, L503.3, U503.1
unnamed: C513.1, L504.4, U505.16
unnamed: C513.2, C515.2, C518.2, D505.2, FB504.1, U505.10
unnamed: C515.1, D505.1, FB503.1, U505.9
unnamed: C516.1, C517.1, FB503.2, R510.2, U506.3
unnamed: C518.1, L504.3, U505.1
unnamed: C602.1, D602.2, D603.1, K601.3, U601.3, U601.6, U602.4, U604.4
unnamed: C603.1, D602.1, R601.1, U601.5, U605.8
unnamed: C604.1, R610.1, R617.1, U601.2
unnamed: C607.1, U612.1
unnamed: C608.1, C609.1, FB601.2, U612.13
unnamed: C614.1, FB602.2, U611.5
unnamed: C617.1, U612.31
unnamed: C618.1, U612.47
unnamed: C624.1, U612.5, Y601.3
unnamed: C625.1, U612.6, Y601.1
unnamed: C631.1, U612.4, Y602.1
unnamed: C632.1, U612.3, Y602.2
unnamed: C707.1, R713.2, R718.1, U706.14
unnamed: C708.1, U706.2, Y701.1
unnamed: C709.1, U706.3, Y701.3
unnamed: C711.1, FB701.2, U711.5
unnamed: C912.2, R906.1
unnamed: C1001.1, U1003.10
unnamed: C1101.1, J1101.2, U1101.155
unnamed: C1102.2, D1102.1, U1101.169
unnamed: C1103.1, U1101.113
unnamed: D201.1, R217.1
unnamed: D201.2, R216.1, U202.2
unnamed: D202.1, R218.1
unnamed: D202.2, U202.3
unnamed: D501.2, R509.1
unnamed: D503.1, F501.2, Q501.3, R507.1, U504.1
unnamed: D504.2, R508.2, R509.2
unnamed: D705.2, R704.2
unnamed: D706.2, R706.2
unnamed: D901.1, D902.2, R901.2
unnamed: D902.3, R903.2, R904.1, U901.3, U901.6, U901.8
unnamed: D1101.2, R1105.1
unnamed: D1101.3, R1106.1
unnamed: D1101.4, R1107.1
unnamed: D1102.2, L1101.2, U1101.170, U1101.171
unnamed: D1103.2, R1142.2
unnamed: D1104.2, R1143.2
unnamed: J1101.1, R1109.2
unnamed: J1103.5, R1145.1
unnamed: J1103.8, R1147.1
unnamed: K601.8, R605.2, U604.3
unnamed: K701.3, U712.4
unnamed: L201.9, U203.4
unnamed: L201.10, R213.1
unnamed: L201.11, U203.1
unnamed: L201.14, U201.4
unnamed: L201.15, R214.1
unnamed: L201.16, U201.1
unnamed: L501.2, U501.1
unnamed: L502.2, U502.1
unnamed: L901.2, R904.2
unnamed: Q501.1, U504.3
unnamed: Q601.1, R612.1
unnamed: Q601.3, R609.1, R610.2
unnamed: Q602.1, R619.1
unnamed: Q603.1, R621.1
unnamed: Q701.1, R705.1, R707.2
unnamed: Q702.1, R728.1
unnamed: Q703.1, R729.1
unnamed: Q704.1, R732.1
unnamed: Q705.1, R733.1
unnamed: Q705.3, R730.2, R731.1, U713.4
unnamed: R205.1, U202.17
unnamed: R206.1, U202.18
unnamed: R207.1, U202.16
unnamed: R210.1, U202.10
unnamed: R212.2, U202.24
unnamed: R215.1, U202.14
unnamed: R401.2, U403.7
unnamed: R402.2, U403.6
unnamed: R507.2, U504.6
unnamed: R511.1, R512.1, U506.1
unnamed: R602.1, U602.1
unnamed: R603.2, U604.2
unnamed: R604.2, R605.1
unnamed: R608.2, U605.5
unnamed: R609.2, U607.1
unnamed: R611.1, U608.3
unnamed: R612.2, R619.2, U608.7
unnamed: R613.1, R615.1, R616.2, U607.2
unnamed: R614.2, R618.1, U607.5
unnamed: R616.1, R617.2
unnamed: R621.2, U612.14
unnamed: R622.2, R625.2, U612.43
unnamed: R623.1, U612.60
unnamed: R624.2, U612.42
unnamed: R626.2, U612.44
unnamed: R627.2, U612.45
unnamed: R630.2, U612.28
unnamed: R631.2, U612.57
unnamed: R709.2, U706.21
unnamed: R711.1, U706.7
unnamed: R712.1, U706.8
unnamed: R714.1, U706.6
unnamed: R722.2, R723.2, U708.4
unnamed: R727.1, U712.1
unnamed: R902.2, R903.1, U901.12
unnamed: R905.1, U905.5
unnamed: R908.1, R909.1, U906.1
unnamed: R1001.2, R1003.1, U1001.3
unnamed: R1002.2, R1004.1, U1002.3
unnamed: R1005.2, R1007.1, U1001.5
unnamed: R1006.2, R1008.1, U1002.5
unnamed: R1009.2, R1011.1, U1004.3
unnamed: R1010.2, R1012.1, U1005.3
unnamed: R1013.2, R1015.1, U1004.5
unnamed: R1014.2, R1016.1, U1005.5
unnamed: R1102.2, U1101.86
unnamed: R1103.2, U1101.79
unnamed: R1104.2, U1101.107
unnamed: R1110.1, U1101.122
unnamed: R1111.1, U1101.123
unnamed: R1112.1, U1101.120
unnamed: R1113.1, U1101.119
unnamed: R1114.1, U1101.125
unnamed: R1115.1, U1101.124
unnamed: R1116.1, U1101.184
unnamed: R1120.1, SW1101.7
unnamed: R1121.1, SW1101.8
unnamed: R1122.1, SW1101.9
unnamed: R1123.1, SW1101.10
unnamed: R1124.1, SW1101.11
unnamed: R1125.1, SW1101.12
unnamed: R1126.2, U1101.166
unnamed: R1127.2, U1101.165
unnamed: U603.1, U603.2, U606.1
unnamed: U603.6, U603.7, U606.2
unnamed: U606.3, U608.1, U608.2
unnamed: U606.4, U607.6, U607.7
unnamed: U902.3, U903.3
unnamed: U903.4, U904.3
unnamed: U903.5, U905.3
unnamed: U1101.167, U1101.168
USB0_VBUS: C404.1, C501.1, C502.1, FB402.2, R501.1, U501.5, U1101.82
USB0_VCC: C405.1, C406.1, C613.1, FB402.1, R624.1, R1009.1, U402.5, U611.1, U611.3
USB1_VBUS: C401.1, C504.1, C505.1, FB401.2, R504.1, U502.5, U1101.75
USB1_VCC: C402.1, C403.1, C710.1, FB401.1, R1013.1, U401.5, U711.1, U711.3
V_SYS: C503.1, C506.1, L501.1, L502.1, L1101.1, R1010.1, U501.6, U502.6, U1101.172, U1101.173
