BehrensG/ETH1CJTAG/(commit log)

2019-06-16 Added hardware project folder structure
    [ETH1CJTAG.kicad_pcb, ETH1CJTAG.sch]
2019-06-16 Schematic library development. Added chiliSOM, ethernet, microUSB and USB schematics.
    [ETH1CJTAG.sch, Ethernet.sch, SOM.sch, USB.sch, microSD.sch]
2019-06-16 Small changes
    [ETH1CJTAG.sch, Ethernet.sch, Power.sch, SOM.sch, USB.sch, microSD.sch]
2019-06-17 Power supply schematic.
    [Power.sch]
2019-06-20 PSU and Power schematic development
    [Connector.sch, ETH1CJTAG.sch, Ethernet.sch, PSU.sch, Power.sch, SOM.sch, USB.sch, microSD.sch]
2019-07-03 Added Trigger.sch
    [Trigger.sch]
2019-07-03 Added Test.sch
    [Connector.sch, ETH1CJTAG.sch, Ethernet.sch, JTAG.sch, PSU.sch, Power.sch, SOM.sch, Test.sch]
2019-07-09 Schematic update and check
    [Connector.sch, ETH1CJTAG.sch, Ethernet.sch, JTAG.sch, PSU.sch, Power.sch, SOM.sch, Test.sch]
2019-07-11 PCB layout
    [Connector.sch, ETH1CJTAG.kicad_pcb, JTAG.sch, Power.sch, SOM.sch, USB.sch]
2019-07-12 PCB design
    [ETH1CJTAG.kicad_pcb, JTAG.sch, PSU.sch, SOM.sch, USB.sch]
2019-07-27 PCB done
    [Power.sch]
2019-07-28 PCB zones modified
2019-08-09 BOM created, footprint fixes.
    [ETH1CJTAG.ods, ETH1CJTAG.sch, Ethernet.sch, JTAG.sch, PSU.sch, Power.sch, SOM.sch, Test.sch]
2019-08-09 Modification of power planes
2019-08-12 Added pre-regulator circuit to the PSU. Need to redesing the PCB.
    [ETH1CJTAG.ods, PSU.sch]
2019-08-13 PCB layout for the pre-regulator circuit. Missing EPOT.
    [PSU.sch]
2019-08-18 Footprints update
    [ETH1CJTAG.ods]
2019-08-26 Added new parts to BOM list. PCB ready.
    [Connector.sch, ETH1CJTAG.ods, ETH1CJTAG.sch, Ethernet.sch, JTAG.sch, PSU.sch, Power.sch, SOM.sch]
2019-09-12 Changed capacitor 220u/50V to 100u/50V. 220u was too large for the DC/DC converter as capacitive load.
    [ETH1CJTAG.ods, Power.sch]
